cjsatuforc/Basic-3D-Printer-controller/Basic 3D printer controller.ods

Sheet: BOM
Basic 3D printer board BOM
Item | Manufacturer part # | Package | Qty | Farnell # | Mouser # | RS # | Rapid | Toby | Price ea 100 | Line cost | Notes
SMD parts
Microcontroller | ATSAM4S4BA-AU | LQFP64 | 1 | 1841656 |  |  |  |  | £3.350 | £3.35
Buffer, inverting | 74HCT04 | TSSOP | 1 | 2342495 |  |  |  |  | £0.053 | £0.05
3.3V LDO regulator | XC6206P332MR | SOT23 | 1 | 8796980 |  |  |  |  | £0.202 | £0.20
Power mosfet | IPD036N04L G | DPAK | 1 | 1775568 |  |  |  |  | £0.581 | £0.58 | For heated bed
Power mosfet | NTD5804NT4G | DPAK | 2 | 2317609 |  |  |  |  | £0.176 | £0.35 | For hot ends
Mosfet | IRLML6344TRPBF | SOT23 | 2 | 1857299 |  |  |  |  | £0.115 | £0.23 | For fans and servos
5V 1A voltage regulator 7805 | KA7805AETU | TO220 | 1 | 1564483 |  |  |  |  | £0.278 | £0.28
LED red SMD | KP-1608SURCK | SMD 603 | 4 | 2290329 |  |  |  |  | £0.046 | £0.19 | No endstop LEDs
Diode | SS13 |  | 2 | 1861425 |  |  |  |  | £0.056 | £0.11
12MHz crystal SMD |  | HC49-S | 1 |  |  | 814-9510P |  |  | £0.138 | £0.14
Micro USB B connector | Molex 47346-0001 |  | 1 | 1568026 |  |  |  |  | £0.544 | £0.54
Micro SD card socket | Amphenol 114-00841-68 |  | 1 | 2293708 |  |  |  |  | £0.536 | £0.54 | I'm open to other suggestions
Resistors, capacitors various |  | SMD 0603 | 36 |  |  |  |  |  | £0.010 | £0.36
Capacitor | 100uF 35V SMD aluminium |  | 10 | 1973347 |  |  |  |  | £0.103 | £1.03 | Or 16V 2284761 £0.054
Through hole parts
Push button | ALPS SKHHLUA010 | SMD right angle | 2 | 2056830 |  |  |  |  | £0.090 | £0.18
8-pin header socket | 2212S-08SG-85 | 2.54mm pitch | 5 | 1593463 |  |  | 19-0057 |  | £0.049 | £0.25
18-pin header socket |  | 2.54mm pitch | 1
27-pin header socket |  | 2.54mm pitch | 1 |  |  |  | 19-0085 |  |  | £0.00 | 9-way would be better, but less easily sourced
10 way 24A terminal block |  | 5.08mm pitch | 1 | 2067352 |  |  | 21-4405 |  | £0.715 | £0.72 | Alternative 2008010 at £0.909 100 off. Could design for 5.0mm pitch instead
51 pins (total) header strip (5x7-way, 6x2-way, 1x4-way) |  | 2.54mm pitch | 1 |  |  |  |  |  | £0.500 | £0.50 | Will be divided into sections. For motors, endstops, thermistors, fans
16 pin 2 row header strip gold plated |  | 2.54mm pitch | 1 | 1022239 |  |  |  |  | £0.266 | £0.27 | Expansion connector
2-pin header |  | 2.54mm pitch
PCB, 2 layer, green FR4, about 100x80x1.6mm, ENIG |  |  | 1 |  |  |  |  |  | £1.500 | £1.50 | 2oz copper for top and bottom layers
Total parts cost |  |  |  |  |  |  |  |  |  | £11.36
With Molex connectors:
2 way KK | Molex 22-23-2021 |  | 6 | 1462926 |  |  |  |  | £0.059 | £0.36
3 way KK | Molex 22-23-2031 |  | 4 | 1462950 |  |  |  |  | £0.084 | £0.34
4 way KK | Molex 22-23-2041 |  | 6 | 1462920 |  |  |  |  | £0.123 | £0.74
Total parts cost |  |  |  |  |  |  |  |  |  | £12.29
Assembly cost (estimated, UK assembly) |  |  |  |  |  |  |  |  |  | £9.00
Total parts + assembly cost (inc. Molex connectors) |  |  |  |  |  |  |  |  |  | £21.29

Sheet: SAM3S4B pin usage
Pin assignments
Port | SAM3S4B special function | RK function | SAM3X8E special function | Duet function | Notes
PA0 | PWMH0 | Expansion encoder 1 | PWML3 | E0 step
PA1 | PWMH1 | DIR |  | E0 dir
PA2 | SCK0, PWMH2 | Expansion encoder 2 | AD0 | Expansion AD0
PA3 | TWD0, NPCS3 | Expansion TWD |  | Z stop
PA4 | TWCK0 | Expansion TWC | AD2 | Bed thermistor
PA5 | RxD0, NPCS3 | ESP8266 out |  | E0 en
PA6 | TxD0, PWMH3 | ESP8266 in | AD3 | E0 thermistor
PA7 | RTS0 | X endstop |  | E0 stop
PA8 | CTS0 | Y endstop |  | Expansion URxD1
PA9 | URXD0, NPCS1 | Expansion URxD |  | Expansion UTxD1
PA10 | UTXD0, NPCS2 | Expansion UTxD |  | Expansion RxD0
PA11 | NPCS0, PWMH0 | Expansion SS |  | Expansion TxD0
PA12 | MISO, PWMH1 | Expansion MISO |  | Expansion RxD1
PA13 | MOSI, PWMH2 | Expansion MOSI |  | Expansion TxD1
PA14 | SPCK, PWMH3 | Expansion SPCK |  | Expansion RTS1
PA15 | PWML3 | Expansion encoder 3 |  | Expansion CTS1
PA16 | PWML2 | Bed heater |  | Expansion PA16/AD7
PA17 | AD0 | Bed thermistor |  | Expansion(?) TWD0
PA18 | AD1 | E0 thermistor |  | TWCK0
PA19 | AD2, PWML0 | E1 header |  | MCCK
PA20 | AD3, PWML1 | E0 heater |  | MCCDA
PA21 | AD8, RxD1 | Z probe in |  | MCDA0
PA22 | AD9, TxD1, NPCS3 | Z probe out |  | MCDA1
PA23 | SCK1, PWMH0 | Zendstop |  | MCDA2
PA24 | RTS1, PWMH1 | Fan 1 (pwm) |  | MCDA3
PA25 | CTS1, PWMH2 | XYZ enable |  | SPI_MISO
PA26 | MCDA2 | SDHC |  | SPI_MOSI
PA27 | MCDA3 | SDHC |  | SPI_SPCK
PA28 | MCCDA | SDHC |  | SPI_NPCS0
PA29 | MCCK | SDHC |  | SPI_NPCS1
PA30 | MCDA0, NPCS2, PWML2 | SDHC |  | n/a
PA31 | MCDA1 | SDHC |  | n/a
PB0 | PWMH0, AD4 | E1 thermistor |  | Ethernet
PB1 | PWMH1, AD5 | X step |  | Ethernet
PB2 | URXD1, AD6 | Y step |  | Ethernet
PB3 | UTXD1, AD7 | Z step |  | Ethernet
PB4 | PWMH2 | E0 enable |  | Ethernet
PB5 | PWML0 | E0 step |  | Ethernet
PB6 |  | E1 enable |  | Ethernet
PB7 |  | E1 step |  | Ethernet
PB8 | XOUT | Crystal |  | Ethernet
PB9 | XIN | Crystal |  | Ethernet
PB10 | DDM | USB |  | UOTGVBOF
PB11 | DDP | USB |  | UOTGID
PB12 | Erase, PWML1 | Erase |  | TWD1
PB13 | DAC0, PWML2, NPCS2 | Axis current |  | TWCK1
PB14 | DAC1, PWMH3 | Extruder current |  | Expansion PWMH2
PB15 | n/a |  |  | Expansion PB15
PB16 | n/a |  |  | Expansion PB16
PB17 | n/a |  |  | Expansion AD10
PB18 | n/a |  |  | Expansion AD11
PB19 | n/a |  |  | Expansion AD12
PB20 | n/a |  |  | Expansion AD13
PB21 | n/a |  |  | Expansion AD14
PB22 | n/a |  |  | unused
PB23 | n/a |  |  | unused
PB24 | n/a |  |  | unused
PB25 | n/a |  |  | unused
PB26 | n/a |  |  | unused
PB27 | n/a |  |  | SD_CD
PB28 | n/a |  |  | Jtag
PB29 | n/a |  |  | Jtag
PB30 | n/a |  |  | Jtag
PB31 | n/a |  |  | Jtag
PC0 | n/a |  |  | Erase
PC1 | n/a |  |  | Ufault
PC2 | n/a |  | PWML0 | Fan0
PC3 | n/a |  |  | Expansion PWMH0
PC4 | n/a |  |  | Expansion PWML1
PC5 | n/a |  |  | Expansion PWMH1
PC6 | n/a |  |  | Expansion PWML2
PC7 | n/a |  |  | Expansion PWMH2
PC8 | n/a |  | PWML3 | E0 heater
PC9 | n/a |  |  | Expansion PWMH3
PC10 | n/a |  |  | unused
PC11 | n/a |  |  | Expansion PC11
PC12 | n/a |  |  | Expansion PC12
PC13 | n/a |  |  | Expansion PC13
PC14 | n/a |  |  | Expansion PC14
PC15 | n/a |  |  | Expansion PC15
PC16 | n/a |  |  | Expansion PC16
PC17 | n/a |  |  | Expansion PC17
PC18 | n/a |  |  | Expansion PWMH6
PC19 | n/a |  |  | Expansion PWMH5
PC20 | n/a |  |  | Expansion PWMH4
PC21 | n/a |  |  | Expansion PWML4
PC22 | n/a |  |  | Expansion PWML5
PC23 | n/a |  |  | Expansion PWML6
PC24 | n/a |  | PWML7 | Bed heater
PC25 | n/a |  |  | Z step
PC26 | n/a |  |  | Z dir
PC27 | n/a |  |  | Z en
PC28 | n/a |  |  | unused
PC29 | n/a |  |  | unused
PC30 | n/a |  |  | unused
PC31 | n/a |  |  | n/a
PD0 | n/a |  |  | Y step
PD1 | n/a |  |  | Y dir
PD2 | n/a |  |  | Y en
PD3 | n/a |  |  | Y stop
PD4 | n/a |  |  | X step
PD5 | n/a |  |  | X dir
PD6 | n/a |  |  | X en
PD7 | n/a |  |  | X stop
PD8 | n/a |  |  | PS_ON
PD9 | n/a |  |  | unused
PD10 | n/a |  |  | unused
PD11 | n/a |  |  | n/a
PD12 | n/a |  |  | n/a
PD13 | n/a |  |  | n/a
PD14 | n/a |  |  | n/a
PD15 | n/a |  |  | n/a
PD16 | n/a |  |  | n/a
PD17 | n/a |  |  | n/a
PD18 | n/a |  |  | n/a
PD19 | n/a |  |  | n/a
PD20 | n/a |  |  | n/a
PD21 | n/a |  |  | n/a
PD22 | n/a |  |  | n/a
PD23 | n/a |  |  | n/a
PD24 | n/a |  |  | n/a
PD25 | n/a |  |  | n/a
PD26 | n/a |  |  | n/a
PD27 | n/a |  |  | n/a
PD28 | n/a |  |  | n/a
PD29 | n/a |  |  | n/a
PD30 | n/a |  |  | n/a
PD31 | n/a |  |  | n/a
Total I/O pins: | 47
Used by Erase | 1
Used by USB | 2
Used by SDHC | 6
Used by crystal | 2
Pins left | 36
Endstops | 3 |  |  |  | Assuming no E0 endstop
Step | 5
Dir | 1 |  |  |  | Assuming all share
En | 3 |  |  |  | Assuming XYZ share
Motor current | 2 |  |  |  | 1 for XYZ, 1 for extruders
Thermistor | 3
Heater | 3
Fan | 1
Zprobe | 2
ESP8266 Tx, Rx | 2
ESP8266 Prog | 1
Expansion pins left | 10
Expansion pin breakdown:
PanelDue Tx, Rx | 2
TWI | 2
SPI | 4 |  |  |  | Two of them also feed 5V buffers for 12864
Rotary encoder | 3 |  |  |  | Also possibility of using them for ADC inputs
Total expansion pins | 11

Sheet: Microstepping
Misc
Microstepping (MS0 is next to EN)
M0/MS1 | M1/MS2 | M2/MS3 | A4982 | A4988 | DRV8825
L | L | L | Full | Full | Full
H | L | L | ½ | ½ | ½
L | H | L | ¼ | ¼ | ¼
H | H | L | 1/16 | “1/8 | “1/8
L | L | H | Full | x | 1/16 | *
H | L | H | ½ | x | 1/32
L | H | H | ¼ | x | 1/32
H | H | H | 1/16 | 1/16 | 1/32 | *
Conclusion:
MS1, MS2 connect together, generally H, but L for 1/16 on drv8825
MS3 always H
