cjsatuforc/Basic-3D-Printer-controller/RK.brd

## EAGLE design RK.brd (2016-02-21)

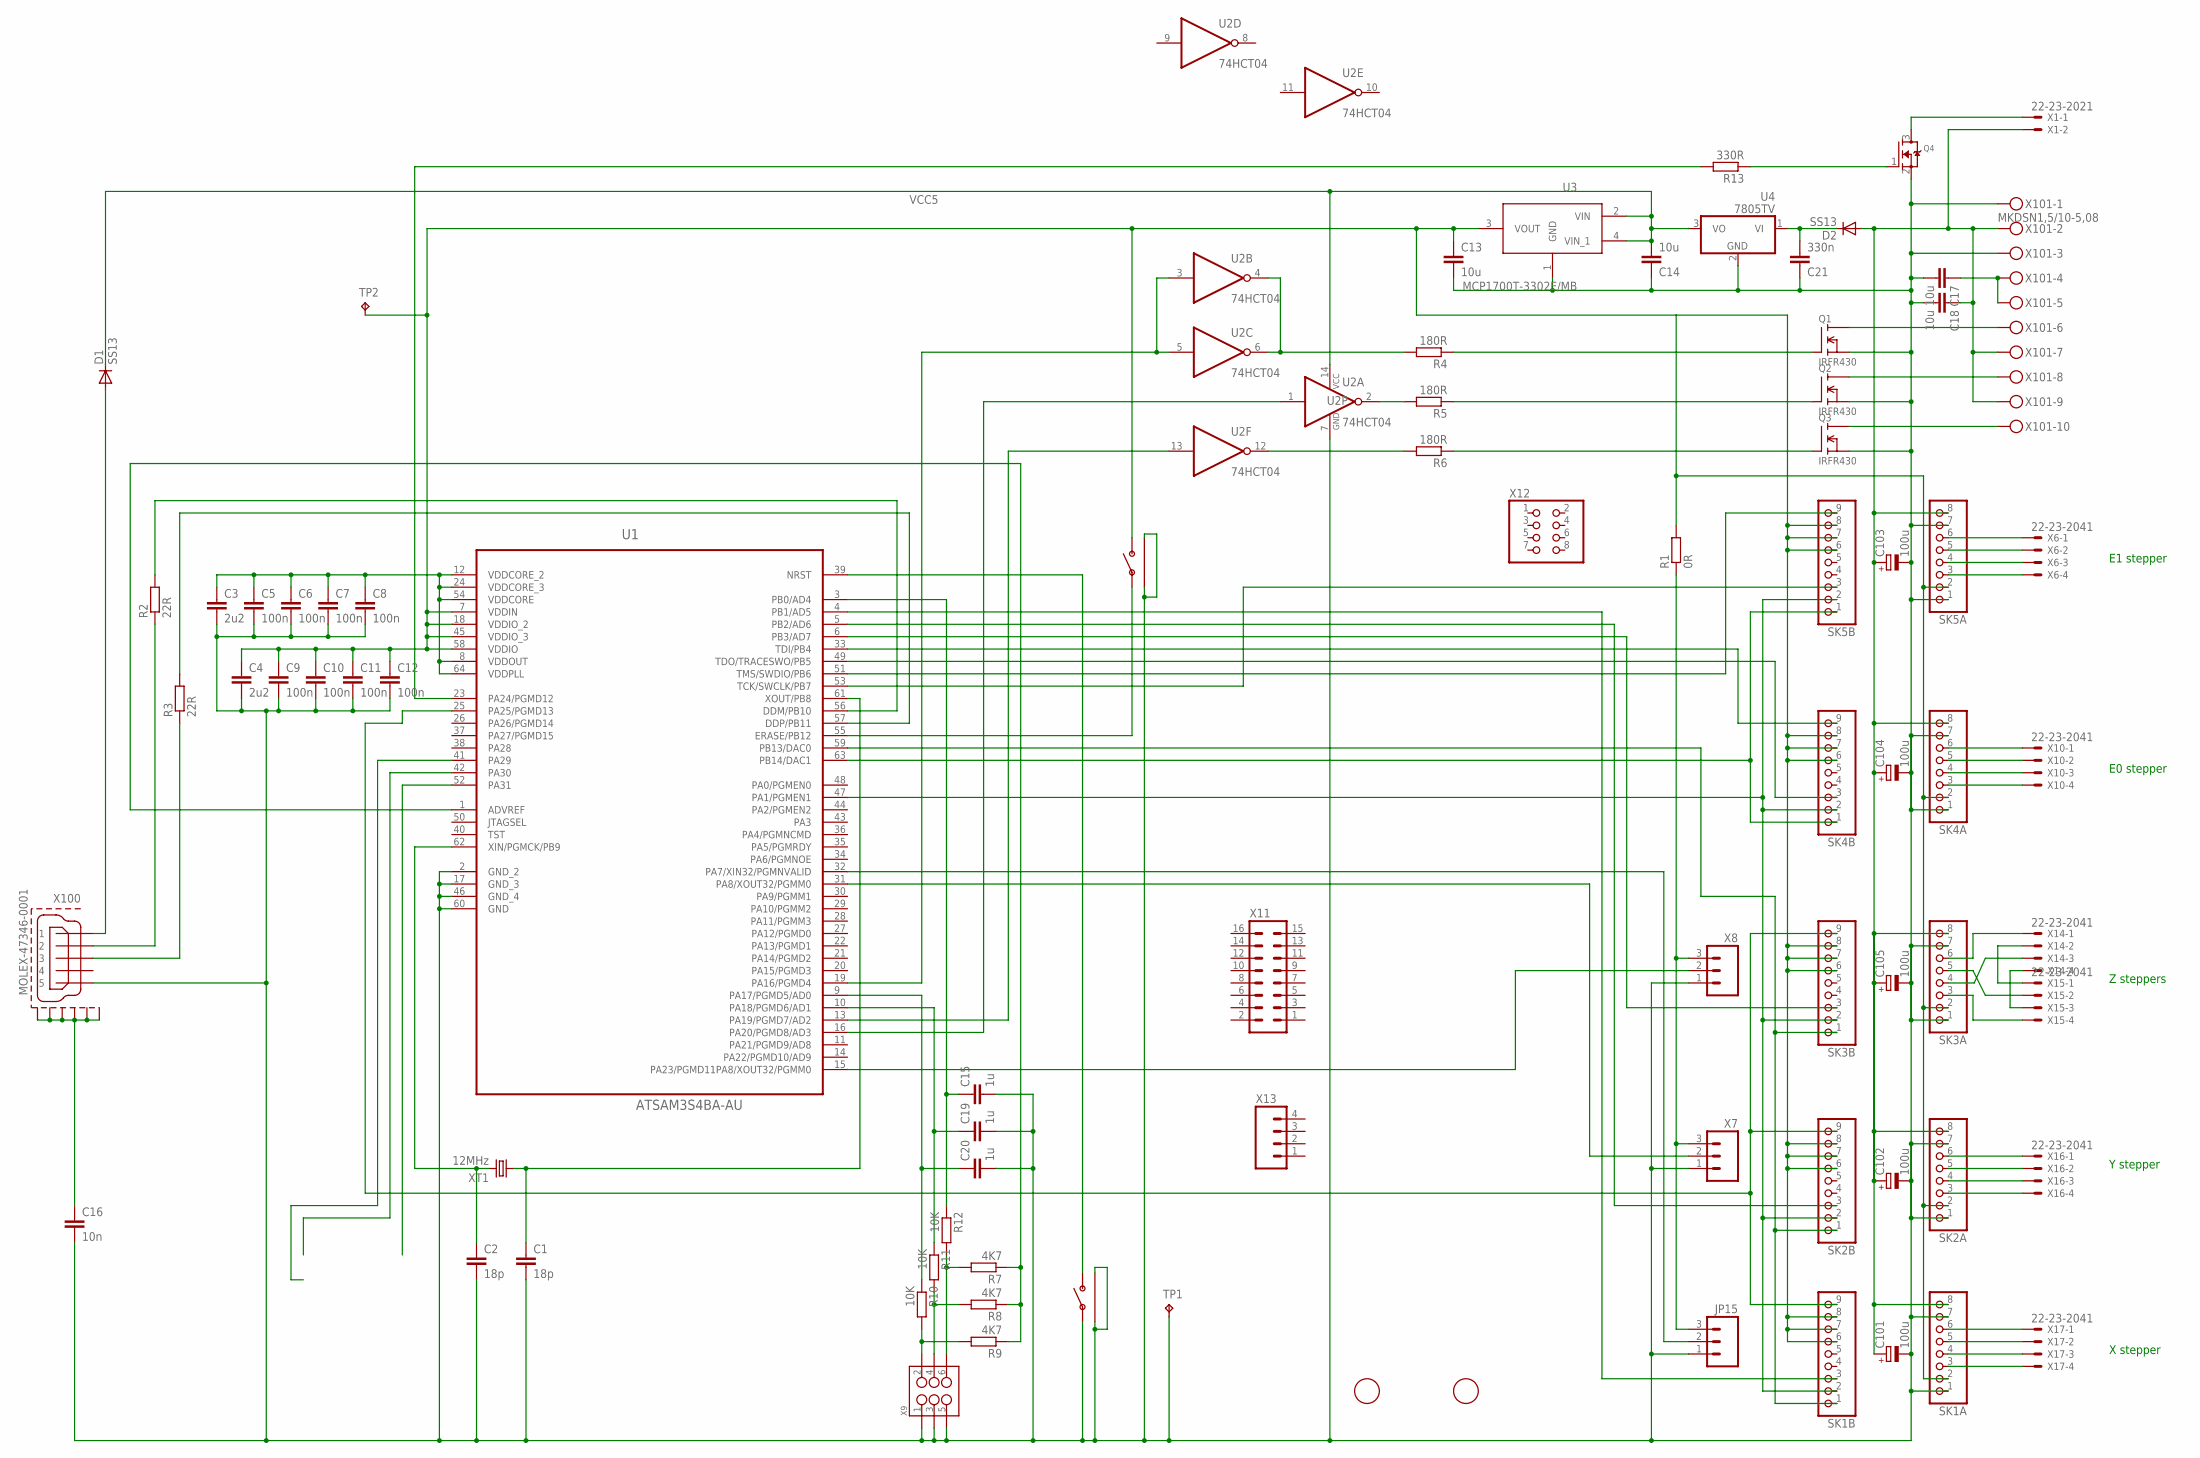
[picture p1: schematic RK.sch]

Parts:
C1, C2: 18p; C0603
C3, C4: 2u2; C0603
C5, C6, C7, C8, C9, C10, C11, C12: 100n; C0603
C13, C14: 10u; C0805
C15, C19, C20: 1u; C0603
C16: 10n; C0603
C17, C18: 10u; C0805K
C21: 330n; C0805
C101, C102, C103, C104, C105: 100u; PANASONIC_D
D1, D2: SS13; DO214AC
JP15: M03PTH; 1X03
Q1, Q2, Q3: IRFR430; DPAK
Q4: MOSFET-NREFLOW; SOT23
R1: 0R; R0603
R2, R3: 22R; R0603
R4, R5, R6: 180R; R0603
R7, R8, R9: 4K7; R0603
R10, R11, R12: 10K; R0603
R13: 330R; R0603
SK1A, SK2A, SK3A, SK4A, SK5A: PINHD-1X8BIG; 1X08-BIG
SK1B, SK2B, SK3B, SK4B, SK5B: PINHD-1X9; 1X09-BIG
TP1, TP2: TPPAD1-10; P1-10
U1: ATSAM3S4BA-AU; QFP50P1200X1200X160-64N
U2: 74HCT04; TSSOP14
U3: MCP1700T-3302E/MB; SOT150P400X160-4N
U4: 7805TV; TO220V
U$1, U$2: FIDUCIAL; FIDUCIAL_1MM
U$3, U$4: ALPS-SKHHLUA010; SKHHLUA010
X1: 22-23-2021
X6, X10, X14, X15, X16, X17: 22-23-2041
X7, X8: M03PTH; 1X03
X9: M03X22X3_SILK_SM; 2X3
X11: MA08-2
X12: PINHD-2X4; 2X04
X13: M04PTH; 1X04
X100: MOLEX-47346-0001; MOLEX-47364-0001
X101: MKDSN1,5/10-5,08
XT1: 12MHz; HC49U-V

Connections:
BED-VE: Q1.2 (D), X101.6
GND: C1.2, C2.2, C3.2, C4.2, C5.2, C6.2, C7.2, C8.2, C9.2, C10.2, C11.2, C12.2, C13.2, C14.1, C15.2, C16.2, C17.2, C18.2, C19.2, C20.2, C21.1, C101.-, C102.-, C103.-, C104.-, C105.-, JP15.1, Q1.3 (S), Q2.3 (S), Q3.3 (S), Q4.2 (S), SK1A.1, SK1A.7, SK2A.1, SK2A.7, SK3A.1, SK3A.7, SK4A.1, SK4A.7, SK5A.1, SK5A.7, TP1.TP, U1.2 (GND_2), U1.17 (GND_3), U1.46 (GND_4), U1.60 (GND), U2.7 (GND), U3.1 (GND), U4.2 (GND), U$3.P$1, U$3.P$3, U$3.P$4, U$4.P$3, U$4.P$4, X7.1, X8.1, X9.1, X9.3, X9.5, X100.5, X101.1, X101.3
HEATER1-VE: Q2.2 (D), X101.8
HEATER2-VE: Q3.2 (D), X101.10
unnamed: SK1B.2, SK2B.2, SK3B.2, SK4B.2, SK5B.2, U1.47 (PA1/PGMEN1)
unnamed: SK4A.3, X10.4
unnamed: SK4A.4, X10.3
unnamed: SK4A.5, X10.2
unnamed: SK4A.6, X10.1
unnamed: SK1A.3, X17.4
unnamed: SK1A.4, X17.3
unnamed: SK1A.5, X17.2
unnamed: SK1A.6, X17.1
unnamed: SK3A.6, X14.1
unnamed: SK3A.4, X14.3
unnamed: SK3A.3, X15.4
unnamed: X14.2, X15.1
unnamed: X14.4, X15.3
unnamed: SK3A.5, X15.2
unnamed: C18.1, C101.+, C102.+, C103.+, C104.+, C105.+, D2.A, SK1A.8, SK2A.8, SK3A.8, SK4A.8, SK5A.8, X1.2, X101.2, X101.7, X101.9
unnamed: SK5A.3, X6.4
unnamed: R2.2, U1.56 (DDM/PB10)
unnamed: SK5A.4, X6.3
unnamed: SK5A.5, X6.2
unnamed: C1.1, U1.61 (XOUT/PB8), XT1.1
unnamed: C2.1, U1.62 (XIN/PGMCK/PB9), XT1.2
unnamed: U1.55 (ERASE/PB12), U$4.P$1
unnamed: U1.39 (NRST), U$3.P$2
unnamed: SK1B.3, U1.4 (PB1/AD5)
unnamed: C20.1, R10.1, U1.9 (PA17/PGMD5/AD0)
unnamed: R3.2, U1.57 (DDP/PB11)
unnamed: U1.19 (PA16/PGMD4), U2.3 (I), U2.5 (I)
unnamed: U1.13 (PA19/PGMD7/AD2), U2.13 (I)
unnamed: D1.A, X100.1
unnamed: R2.1, X100.2
unnamed: R7.2, R12.2, X9.6
unnamed: R3.1, X100.3
unnamed: R13.2, U1.23 (PA24/PGMD12)
unnamed: SK5A.6, X6.1
unnamed: SK2A.3, X16.4
unnamed: SK2A.4, X16.3
unnamed: SK2A.5, X16.2
unnamed: SK1B.9, SK2B.9, SK3B.9, U1.25 (PA25/PGMD13)
unnamed: SK2A.6, X16.1
unnamed: SK5B.3, U1.53 (TCK/SWCLK/PB7)
unnamed: JP15.3, R1.1, X7.3, X8.3
unnamed: C16.1, X100.GND1, X100.GND2, X100.GND3, X100.GND4, X100.GND5, X100.GND6
unnamed: SK4B.9, U1.33 (TDI/PB4)
unnamed: C17.1, X101.4, X101.5
unnamed: C19.1, R11.1, U1.10 (PA18/PGMD6/AD1)
unnamed: SK4B.1, SK5B.1, U1.63 (PB14/DAC1)
unnamed: SK1B.1, SK2B.1, SK3B.1, U1.59 (PB13/DAC0)
unnamed: R7.1, R8.1, R9.1, U1.1 (ADVREF)
unnamed: SK4B.3, U1.49 (TDO/TRACESWO/PB5)
unnamed: R8.2, R11.2, X9.4
unnamed: SK5B.9, U1.51 (TMS/SWDIO/PB6)
unnamed: SK3B.3, U1.6 (PB3/AD7)
unnamed: SK2B.3, U1.5 (PB2/AD6)
unnamed: U1.15 (PA23/PGMD11PA8/XOUT32/PGMM0), X8.2
unnamed: Q4.3 (D), X1.1
unnamed: U1.31 (PA8/XOUT32/PGMM0), X7.2
unnamed: Q4.1 (G), R13.1
unnamed: Q1.1 (G), R4.1
unnamed: Q2.1 (G), R5.1
unnamed: Q3.1 (G), R6.1
unnamed: R9.2, R10.2, X9.2
unnamed: C15.1, R12.1, U1.3 (PB0/AD4)
unnamed: U1.16 (PA20/PGMD8/AD3), U2.1 (I)
unnamed: R6.2, U2.12 (O)
unnamed: R4.2, U2.4 (O), U2.6 (O)
unnamed: R5.2, U2.2 (O)
unnamed: C21.2, D2.C, U4.1 (VI)
VCC: C4.1, C9.1, C10.1, C11.1, C12.1, C13.1, R1.2, SK1A.2, SK1B.6, SK1B.7, SK1B.8, SK2A.2, SK2B.6, SK2B.7, SK2B.8, SK3A.2, SK3B.6, SK3B.7, SK3B.8, SK4A.2, SK4B.6, SK4B.7, SK4B.8, SK5A.2, SK5B.6, SK5B.7, SK5B.8, TP2.TP, U1.7 (VDDIN), U1.18 (VDDIO_2), U1.45 (VDDIO_3), U1.58 (VDDIO), U3.3 (VOUT), U$4.P$2
VCC5: C14.2, D1.C, U2.14 (VCC), U3.2 (VIN), U3.4 (VIN_1), U4.3 (VO)
VDDCORE: C3.1, C5.1, C6.1, C7.1, C8.1, U1.8 (VDDOUT), U1.12 (VDDCORE_2), U1.24 (VDDCORE_3), U1.54 (VDDCORE), U1.64 (VDDPLL)
X6: JP15.2, U1.32 (PA7/XIN32/PGMNVALID)

Notes on the sheet:
Z steppers
E0 stepper
E1 stepper
Y stepper
X stepper

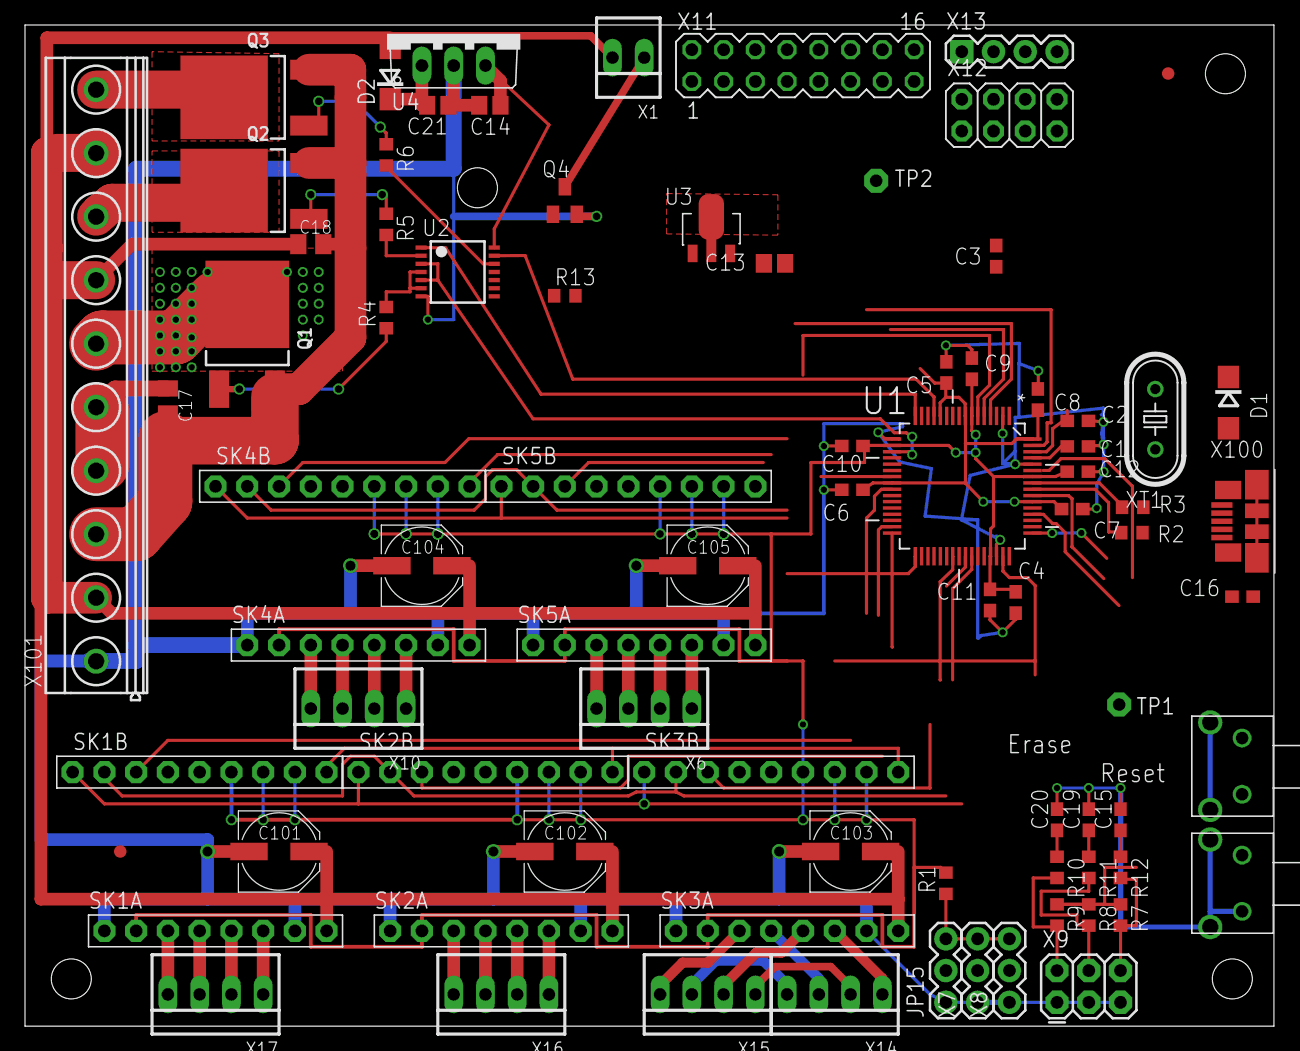
[picture p2: board RK.brd from above]

Board: 2 copper layers, 99.9 x 80.1 mm, 82 parts (0 on the bottom side), 76 nets.
