cjsatuforc/Basic-3D-Printer-controller/(commit log)

2016-02-21 First public commit
    [Basic 3D printer controller.ods, RK.brd, RK.sch]
2016-02-21 Clarified PCB specification
    [Basic 3D printer controller.ods]
2016-02-21 Minor corrections to BOM file
    [Basic 3D printer controller.ods]
